JakubFialkowski/Robot-inspekcyjny/README.md

<h1><b><big># Robot-inspekcyjny</big></b></h1>
Projekt przedstawia budowę prostego robota mobilnego.<br>

<p>-Robot mobilny dwukołowy, z samonastawnym kołem podporowym.<br>
-Serwonapędy modelraskie uzyte jako napęd DC ze zintegrowaną przekładnią, sterowane za pomocą mostka H.<br>
-Pomiar kąta obrotu robota za pomocą modułu MPU6050 (żyroskop + akcelermoetr)<br>
-Wykrywanie przeszkód za pomocą skanera złożonego z czujnika ultradźwiękowego zamontowanego na serwomechanizmie modelarskim<br>
-Dodatkowy cyfrowy czujnik odległości<br>
-sterowany za pomocą modułu Bluetooth oraz stworzonej w tym celu aplikacji<br> 
<b> Szczegółowy opis w pliku Robot mobilny do celów inspekcyjnych.pdf </b></p>
